adefauzann/elbow-rehab-1dof/images/device-cad-front.png

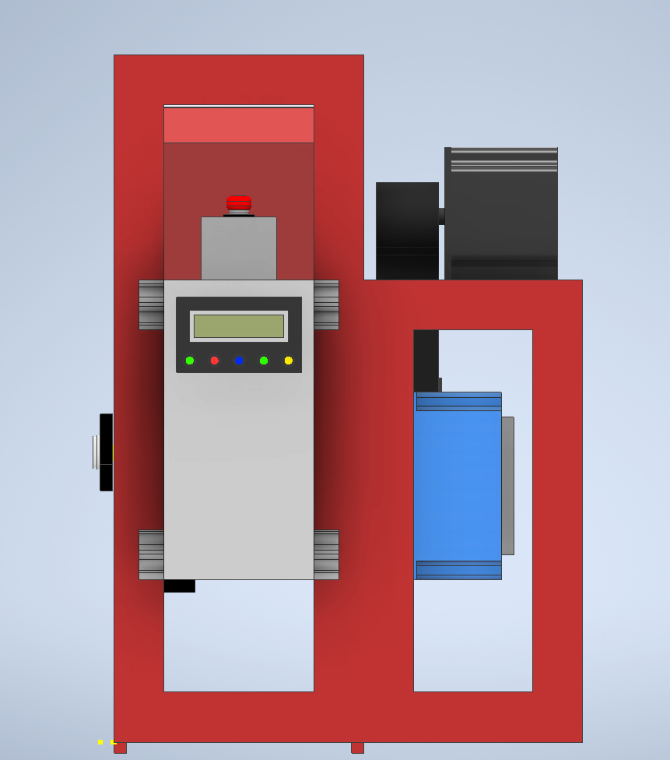
images/device-cad-front.png
