adefauzann/elbow-rehab-1dof/cad/as5600-holder.stl

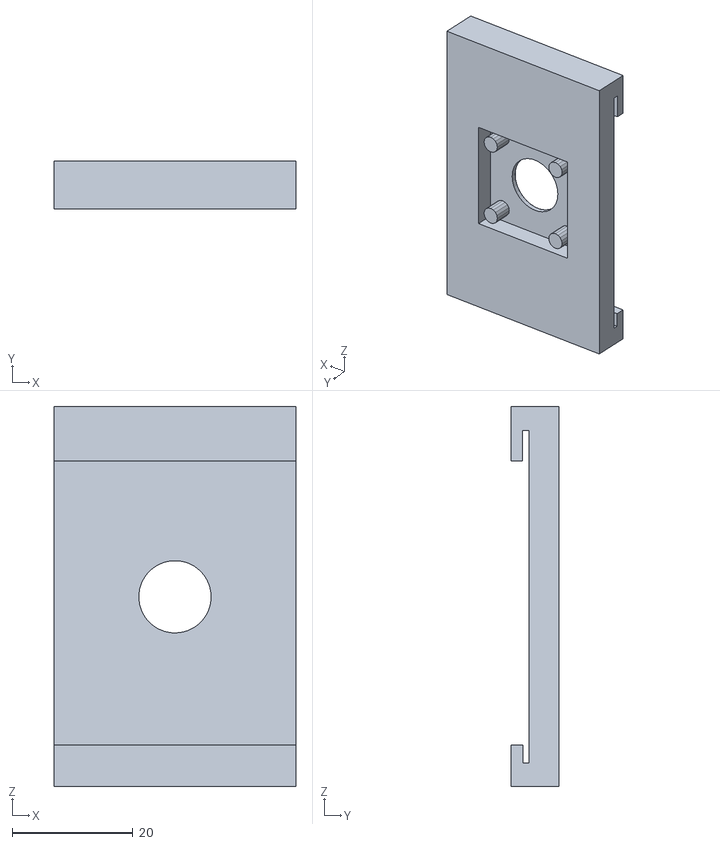
[picture p12: CAD file, 2026-11-07]
cad/as5600-holder.stl
40.0 x 8.00 x 62.9
