adefauzann/elbow-rehab-1dof/(list of files, cad)

Other CAD files:
cad/elbow-rehab.ipt
