adefauzann/elbow-rehab-1dof/images/fuzzy-result.jpg

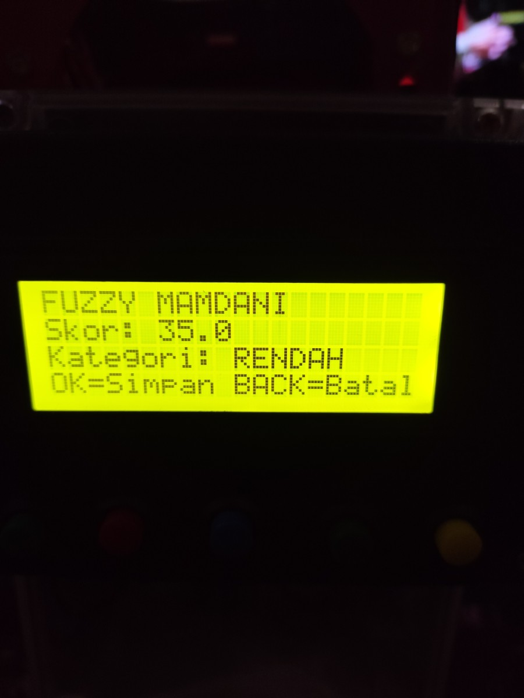
images/fuzzy-result.jpg
