adefauzann/elbow-rehab-1dof/(list of files, drawings)

Other design files:
schematic/elbow-rehab.fzz
